jeffThompson/GamesPlusPlusBadge/README.md

Games++ Badge
==================

Electronic game badges created for [Games++](http://www.gamesplusplus.org) (November 2013), created in collaboration with [Alex Myers](www.alexmyers.info)

For a video demo, see: http://vimeo.com/53818644

\- \- \-

\[ all code available under [Creative Commons BY-NC-SA license](http://creativecommons.org/licenses/by-nc-sa/3.0/) - feel free to use but [please let me know](http://www.jeffreythompson.org) \]
