jeffThompson/GamesPlusPlusBadge/SchematicAndPCB/FancyBadge/PCB-Fancy.pdf

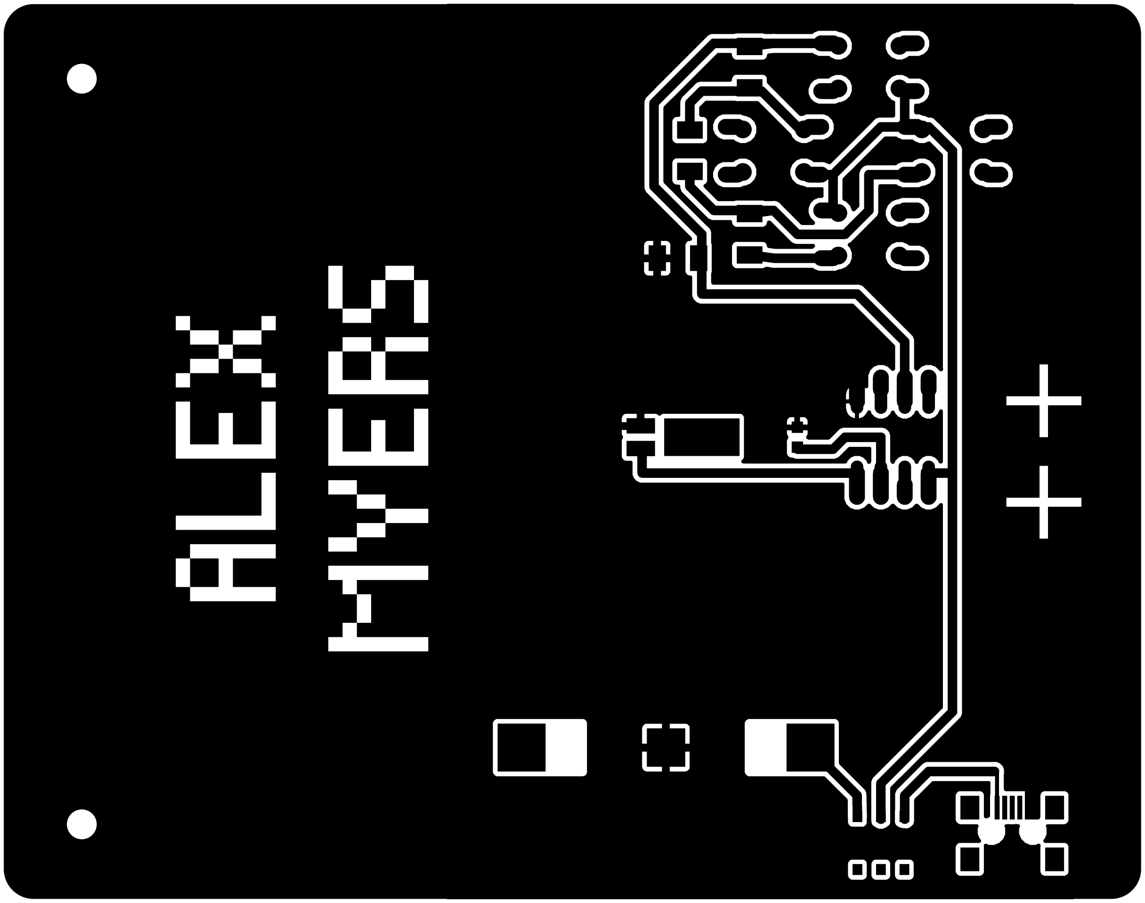
[picture p1: figure]
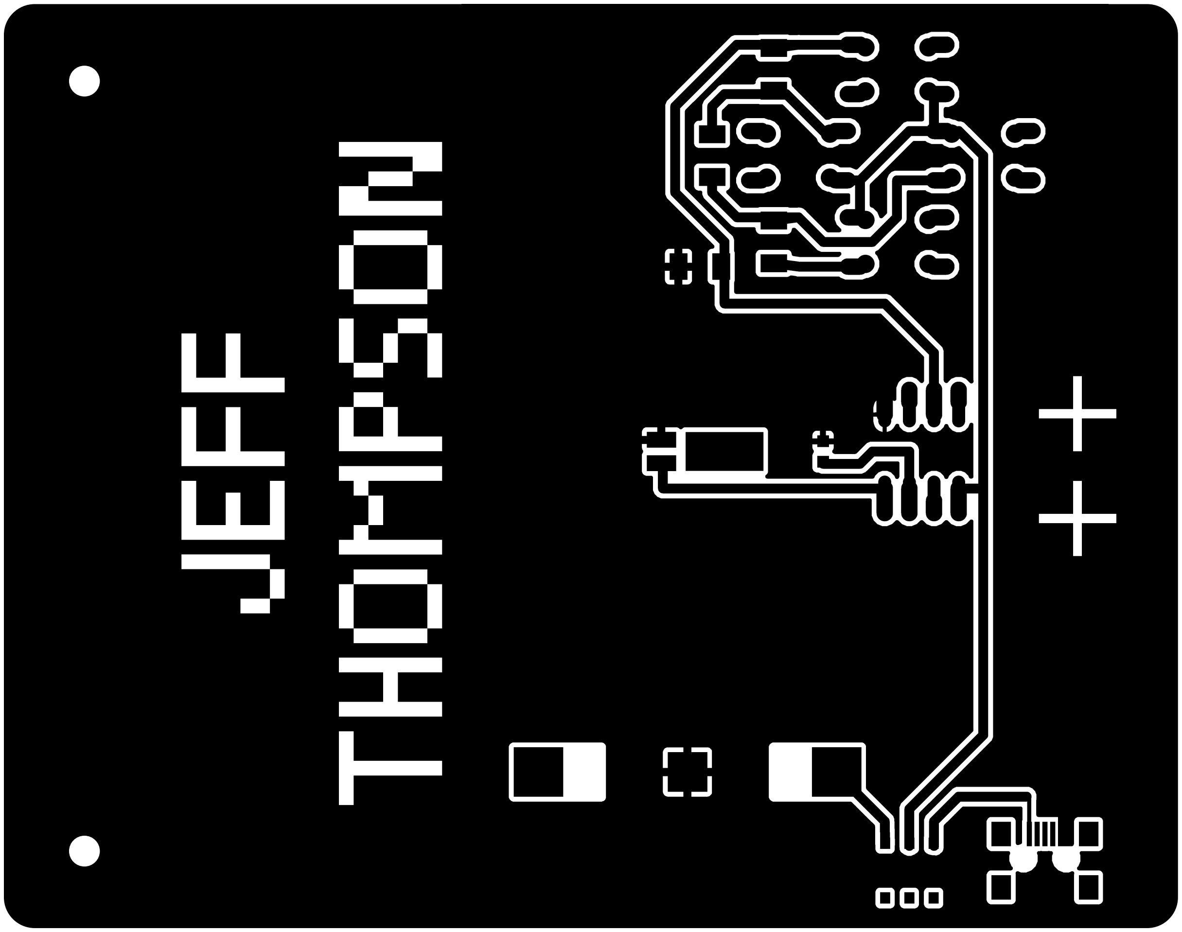
[picture p2: figure]
