jeffThompson/GamesPlusPlusBadge/SchematicAndPCB/InstallationVersion/Schematic.png

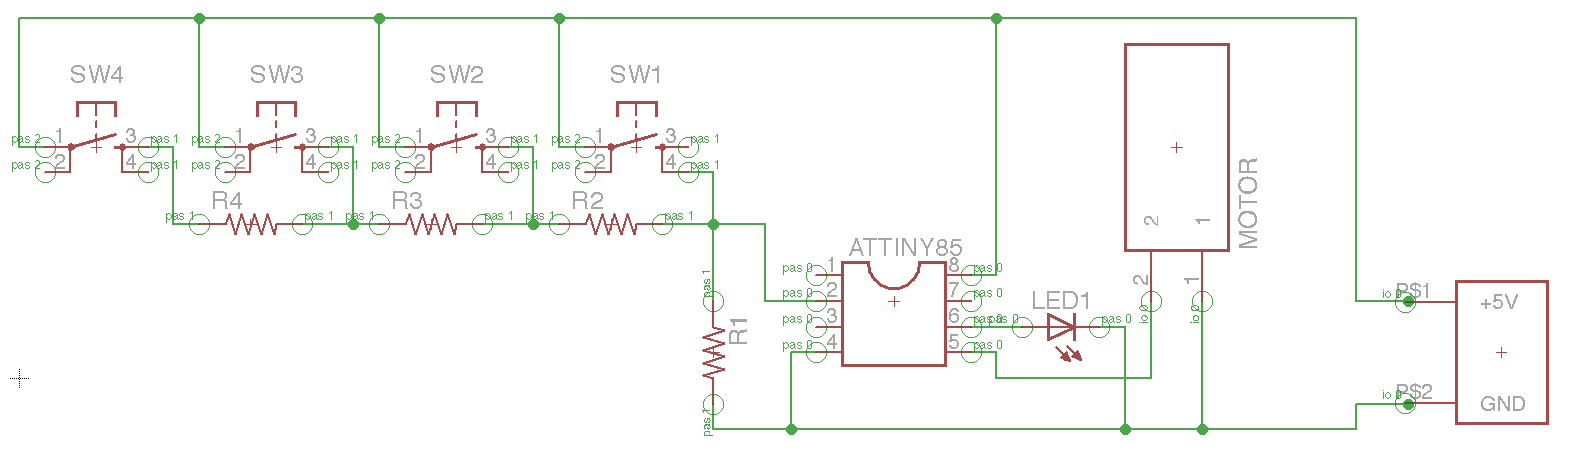
SchematicAndPCB/InstallationVersion/Schematic.png
