jeffThompson/GamesPlusPlusBadge/SchematicAndPCB/InstallationVersion/PCB-Layout.pdf

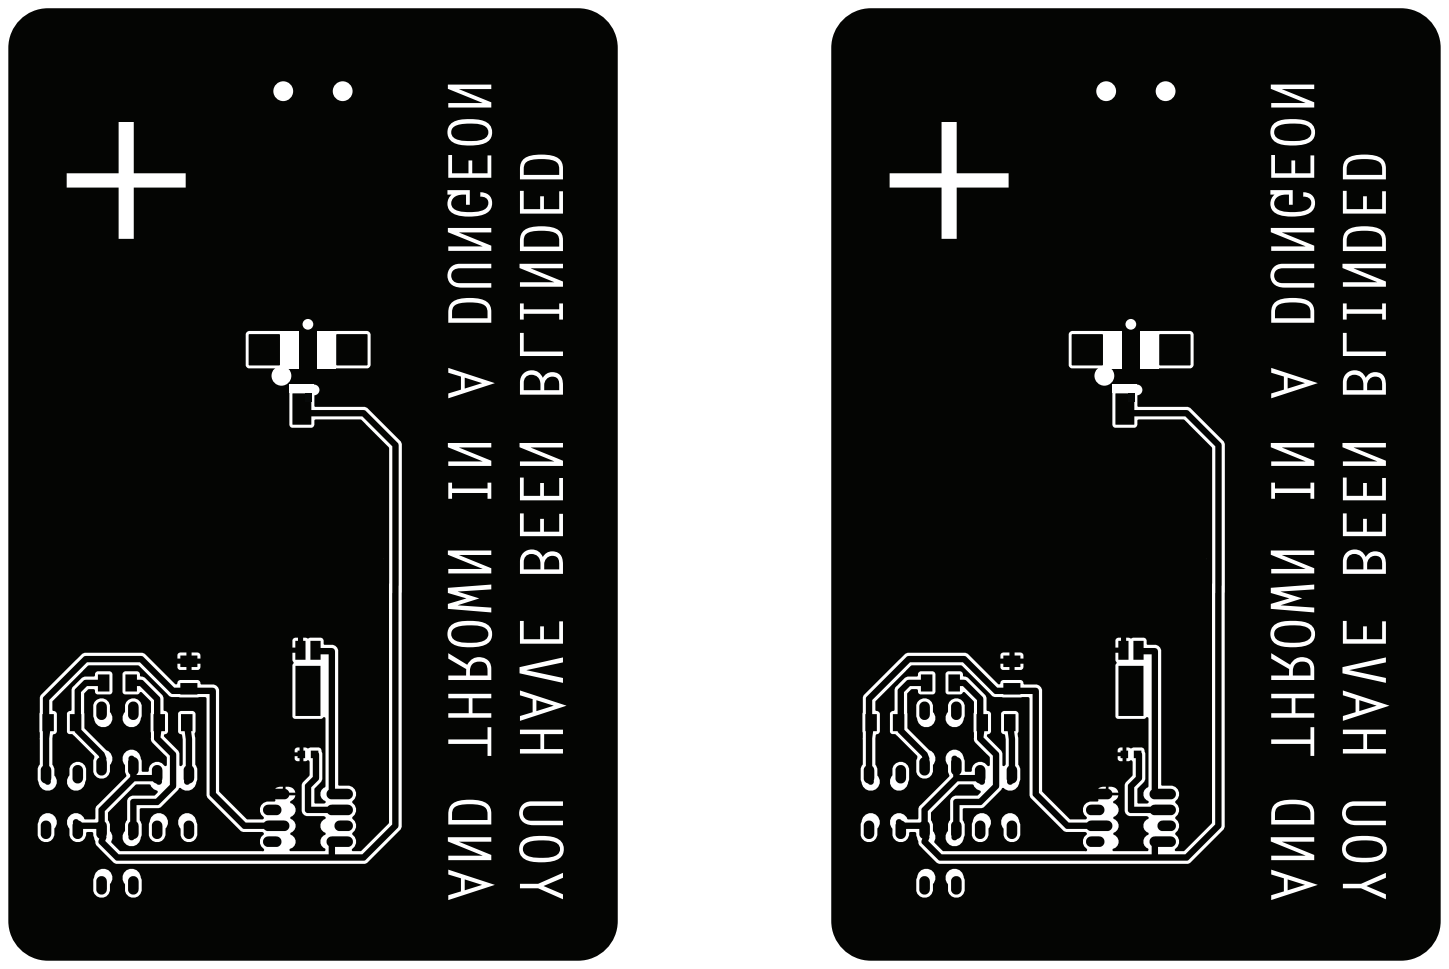
[picture p4: page 1]
