jeffThompson/GamesPlusPlusBadge/SchematicAndPCB/SmallBadge/Badge_Motor.brd

## EAGLE design SchematicAndPCB/SmallBadge/Badge_Motor.brd (2013-01-21)

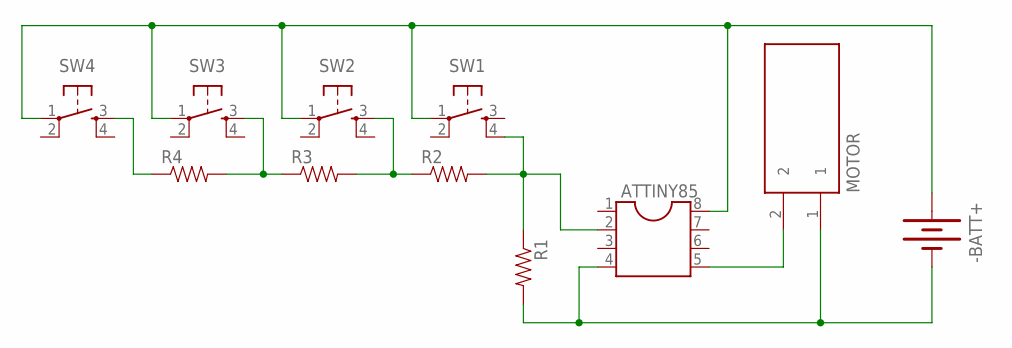
[picture p5: schematic Badge_Motor.sch]

Parts:
-BATT+: BATTERY245MM; BATTCON_245MM
ATTINY85: DIL8S; SOCKET-08
MOTOR: VIB-MOTOR
R1, R2, R3, R4: RESISTOR2010; R2010
SW1, SW2, SW3, SW4: TAC_SWITCHPTH; TACTILE-PTH

Connections:
+3V: -BATT+.1 (+), ATTINY85.8, SW1.1, SW2.1, SW3.1, SW4.1
GND: -BATT+.2 (-), ATTINY85.4, MOTOR.1, R1.2
unnamed: ATTINY85.5, MOTOR.2
unnamed: ATTINY85.2, R1.1, R2.2, SW1.4
unnamed: R4.1, SW4.3
unnamed: R3.1, R4.2, SW3.3
unnamed: R2.1, R3.2, SW2.3

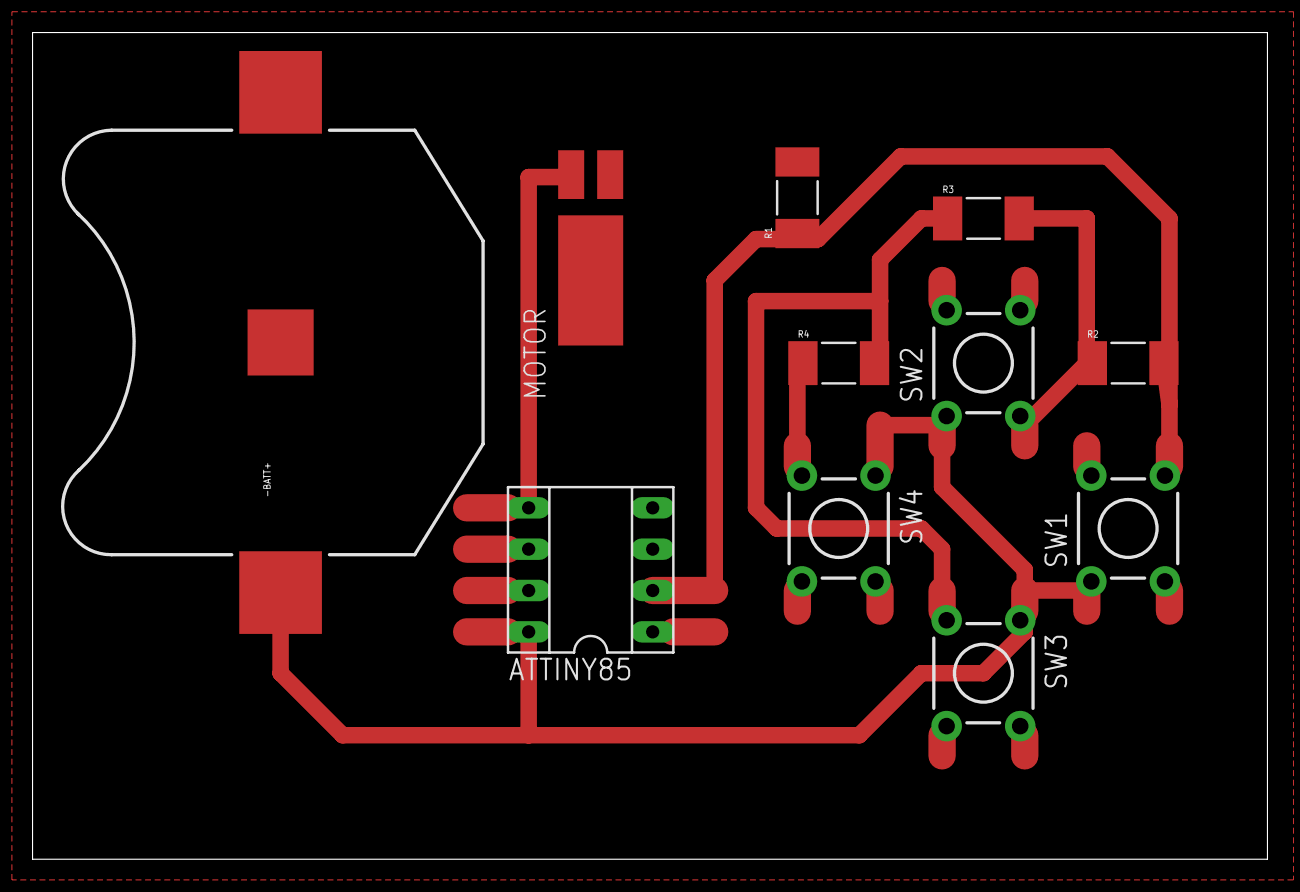
[picture p6: board Badge_Motor.brd from above]

Board: 2 copper layers, 75.9 x 50.8 mm, 11 parts (0 on the bottom side), 7 nets.
