jeffThompson/GamesPlusPlusBadge/SchematicAndPCB/InstallationVersion/InstallPCB.png

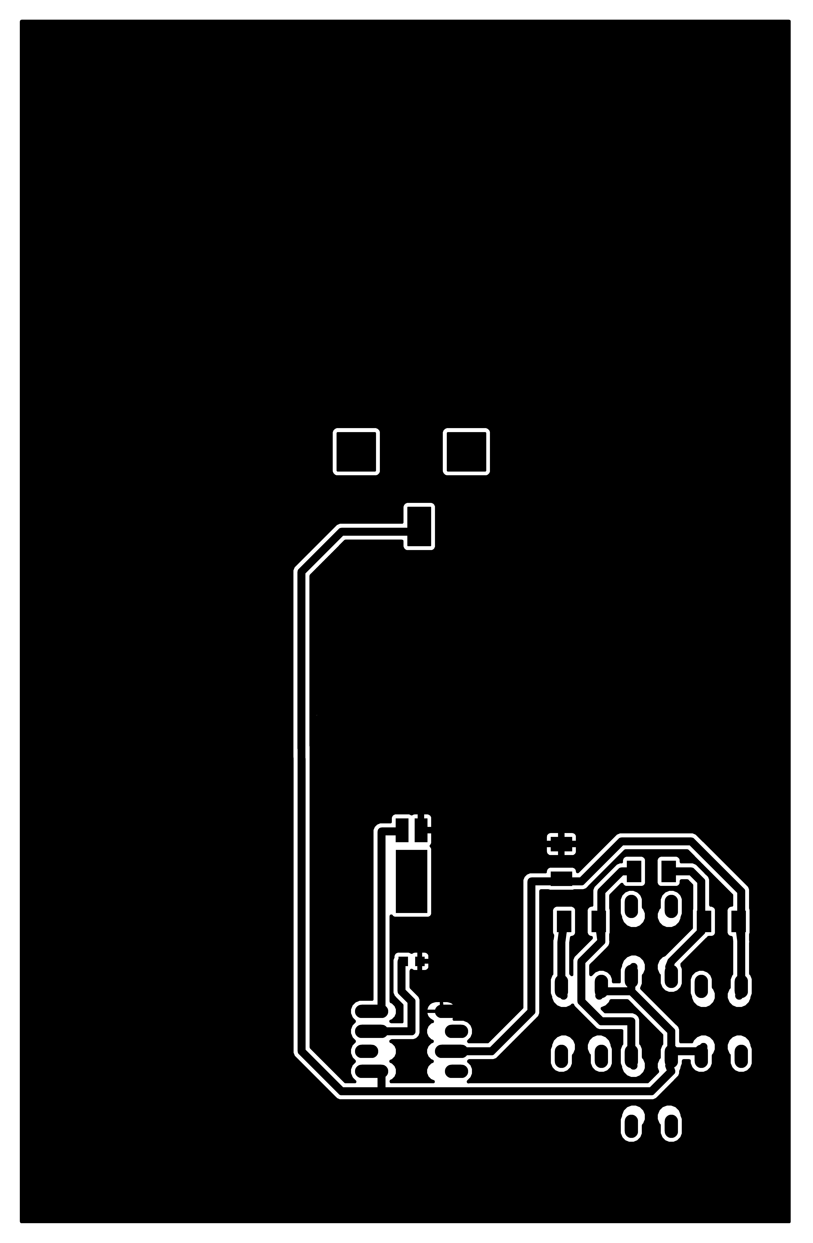
SchematicAndPCB/InstallationVersion/InstallPCB.png
