jeffThompson/GamesPlusPlusBadge/GamesPlusPlus_FinalBadge_SingleLevel/levelArrays.ino

  
/*
  ALL LEVELS - PICK AND ADD TO INTIALIZATION
  
  // LEVEL 1: rubble-dungeon
    byte level[14][14] = {
      {3, 4, 3, 1, 1, 2, 2, 1, 1, 1, 1, 1, 1, 1},
      {2, 3, 3, 3, 3, 1, 2, 2, 1, 2, 2, 1, 1, 2},
      {2, 2, 3, 3, 3, 1, 2, 2, 1, 2, 1, 1, 1, 2},
      {2, 3, 3, 2, 2, 2, 2, 2, 2, 2, 2, 1, 1, 2},
      {2, 2, 2, 2, 2, 2, 2, 2, 3, 3, 2, 1, 2, 2},
      {3, 3, 2, 2, 2, 2, 2, 2, 2, 2, 2, 2, 2, 1},
      {1, 3, 2, 4, 2, 2, 2, 2, 2, 2, 2, 1, 2, 3},
      {1, 3, 3, 3, 3, 3, 3, 2, 2, 1, 2, 2, 2, 3},
      {1, 3, 3, 3, 1, 1, 1, 3, 2, 2, 3, 2, 2, 3},
      {1, 3, 1, 1, 1, 1, 3, 3, 3, 2, 2, 2, 2, 2},
      {3, 3, 1, 2, 2, 2, 3, 1, 1, 1, 1, 2, 2, 2},
      {2, 2, 2, 1, 1, 2, 1, 3, 3, 3, 3, 2, 1, 1},
      {2, 2, 2, 3, 3, 0, 3, 3, 1, 1, 2, 3, 2, 2},
      {1, 1, 2, 3, 3, 2, 1, 1, 1, 2, 2, 2, 2, 1}
    };  
  
  // LEVEL 2: checkerboard/columns
    byte level[14][14] = {
      {1, 2, 1, 2, 1, 2, 1, 2, 1, 2, 1, 2, 1, 4},
      {2, 2, 2, 2, 2, 2, 2, 2, 2, 2, 2, 2, 2, 2},
      {1, 2, 1, 2, 1, 2, 1, 2, 1, 2, 1, 2, 1, 2},
      {2, 2, 2, 2, 2, 2, 2, 2, 2, 2, 2, 2, 2, 2},
      {1, 2, 1, 2, 1, 2, 1, 2, 1, 2, 1, 2, 1, 2},
      {2, 2, 2, 2, 2, 2, 2, 2, 2, 2, 2, 2, 2, 2},
      {1, 2, 1, 2, 1, 2, 1, 2, 1, 2, 1, 2, 1, 2},
      {2, 2, 2, 2, 2, 2, 2, 2, 2, 2, 2, 2, 2, 2},
      {1, 2, 1, 2, 1, 2, 1, 2, 1, 2, 1, 2, 1, 2},
      {2, 2, 2, 2, 2, 2, 2, 2, 2, 2, 2, 2, 2, 2},
      {1, 2, 1, 2, 1, 2, 1, 2, 1, 2, 1, 2, 1, 2},
      {2, 2, 2, 2, 2, 2, 2, 2, 2, 2, 2, 2, 2, 2},
      {1, 2, 1, 2, 1, 2, 1, 2, 1, 2, 1, 2, 1, 2},
      {0, 2, 2, 2, 2, 2, 2, 2, 2, 2, 2, 2, 2, 2}
    };
    
    // LEVEL 3: crisscross
    byte level[14][14] = {
      {2, 2, 0, 2, 2, 2, 2, 2, 2, 2, 2, 2, 2, 2},
      {2, 2, 2, 1, 1, 1, 1, 1, 1, 1, 1, 3, 3, 2},
      {2, 1, 2, 2, 1, 1, 1, 1, 1, 1, 1, 3, 1, 2},
      {2, 1, 1, 2, 2, 1, 1, 1, 1, 1, 3, 3, 1, 2},
      {2, 1, 1, 1, 2, 2, 1, 1, 3, 3, 3, 1, 1, 2},
      {2, 1, 1, 1, 1, 2, 1, 1, 3, 1, 1, 1, 1, 2},
      {2, 1, 1, 1, 1, 2, 2, 3, 3, 1, 1, 1, 1, 2},
      {2, 1, 1, 1, 1, 1, 3, 2, 1, 1, 1, 1, 1, 2},
      {2, 1, 1, 1, 3, 3, 3, 2, 2, 2, 1, 1, 1, 2},
      {2, 1, 1, 1, 3, 1, 1, 1, 1, 2, 1, 1, 1, 2},
      {2, 1, 3, 3, 3, 1, 1, 1, 1, 2, 2, 1, 1, 2},
      {2, 1, 3, 1, 1, 1, 1, 1, 1, 1, 2, 2, 1, 2},
      {2, 3, 3, 1, 1, 1, 1, 1, 1, 1, 1, 4, 2, 2},
      {2, 2, 2, 2, 2, 2, 2, 2, 2, 2, 2, 2, 2, 2}
    };
    
    // LEVEL 4: figure-eight/infinity
    byte level[14][14] = {
      {1, 1, 1, 1, 1, 1, 1, 1, 1, 1, 1, 1, 1, 1},
      {1, 1, 1, 1, 1, 1, 1, 1, 1, 1, 1, 1, 1, 1},
      {1, 3, 3, 3, 3, 3, 3, 3, 3, 3, 3, 3, 3, 1},
      {3, 3, 3, 1, 1, 1, 3, 3, 1, 1, 1, 3, 3, 3},
      {3, 3, 1, 2, 2, 2, 3, 1, 2, 2, 2, 1, 3, 3},
      {3, 1, 2, 2, 1, 2, 2, 2, 2, 1, 2, 2, 1, 3},
      {3, 1, 2, 1, 1, 1, 0, 4, 1, 1, 1, 2, 1, 3},
      {3, 1, 2, 2, 1, 2, 2, 2, 2, 1, 2, 2, 1, 3},
      {3, 3, 1, 2, 2, 2, 1, 3, 2, 2, 2, 1, 3, 3},
      {3, 3, 3, 1, 1, 1, 3, 3, 1, 1, 1, 3, 3, 3},
      {1, 3, 3, 3, 3, 3, 3, 3, 3, 3, 3, 3, 3, 1},
      {1, 1, 1, 1, 1, 1, 1, 1, 1, 1, 1, 1, 1, 1},
      {1, 1, 1, 1, 1, 1, 1, 1, 1, 1, 1, 1, 1, 1},
      {1, 1, 1, 1, 1, 1, 1, 1, 1, 1, 1, 1, 1, 1}
    };
    
    // LEVEL 5: spiral
    byte level[22][22] = {
      {1, 1, 1, 1, 1, 1, 1, 1, 1, 1, 1, 1, 1, 1},
      {1, 2, 2, 2, 2, 2, 2, 2, 2, 2, 2, 2, 2, 1},
      {1, 2, 1, 1, 1, 1, 1, 1, 1, 1, 1, 1, 2, 1},
      {1, 2, 1, 2, 2, 2, 2, 2, 2, 2, 2, 1, 2, 1},
      {1, 2, 1, 2, 1, 1, 1, 1, 1, 1, 2, 1, 2, 1},
      {1, 2, 1, 2, 1, 2, 2, 2, 2, 1, 2, 1, 2, 1},
      {1, 2, 1, 2, 1, 2, 0, 1, 2, 1, 2, 1, 2, 1},
      {1, 2, 1, 2, 1, 2, 2, 1, 2, 1, 2, 1, 2, 1},
      {1, 2, 1, 2, 1, 1, 1, 1, 2, 1, 2, 1, 2, 1},
      {1, 2, 1, 2, 2, 2, 2, 2, 2, 1, 2, 1, 2, 1},
      {1, 2, 1, 1, 1, 1, 1, 1, 1, 1, 2, 1, 2, 1},
      {1, 2, 2, 2, 2, 2, 2, 2, 2, 2, 2, 1, 2, 1},
      {1, 1, 1, 1, 1, 1, 1, 1, 1, 1, 1, 1, 2, 1},
      {4, 2, 2, 2, 2, 2, 2, 2, 2, 2, 2, 2, 2, 1}
    };
    
*/
