jeffThompson/GamesPlusPlusBadge/GamesPlusPlus_FinalBadge_SingleLevel/schematic.ino

/*
SCHEMATIC DESCRIPTION
Because of the limited pins on the ATtiny85, we use a simple hack
to read four buttons into one analog pin - the only other connection
is to the output to the motor

For a full schematic and PCB layout, see the Eagle files.
*/
