jeffThompson/GamesPlusPlusBadge/(commit log)

2013-01-21 Reorganized PCB files
    [Badge_Fancy.brd, Badge_Fancy.sch, Badge_Motor-ExhibitionLarge.brd, Badge_Motor-ExhibitionLarge.sch, Badge_Motor.brd, Badge_Motor.sch]
2013-01-25 Updated PCB for exhibition
2013-02-11 Updated install PCB
2013-02-18 Added LED support for "fancy" badges
